seifmostafa73/3D-Printer/BRD.png

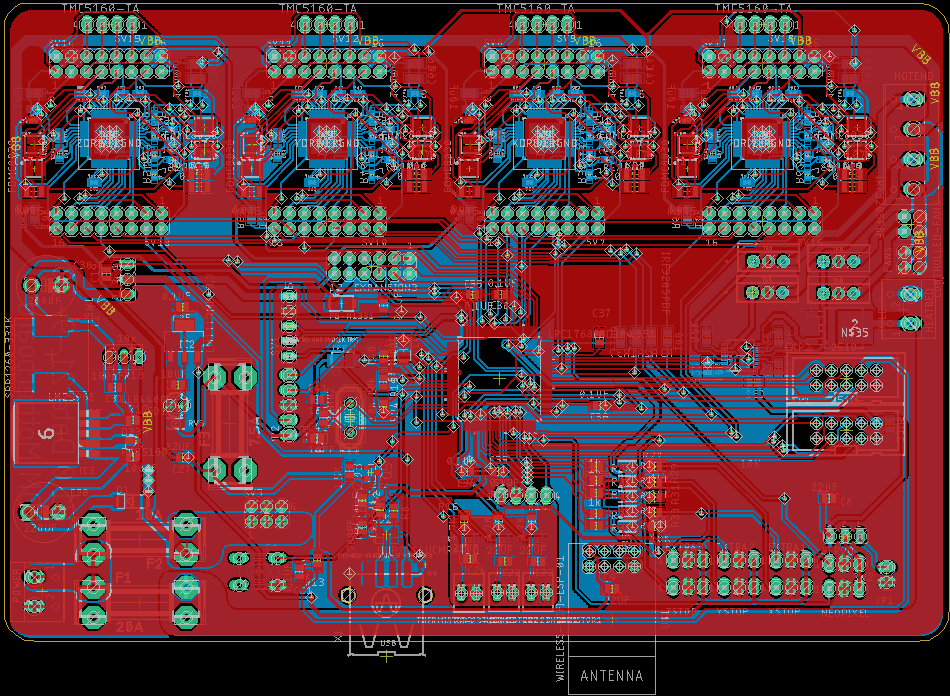
BRD.png
