seifmostafa73/3D-Printer/FDM/Motherboard/Motherboard.png

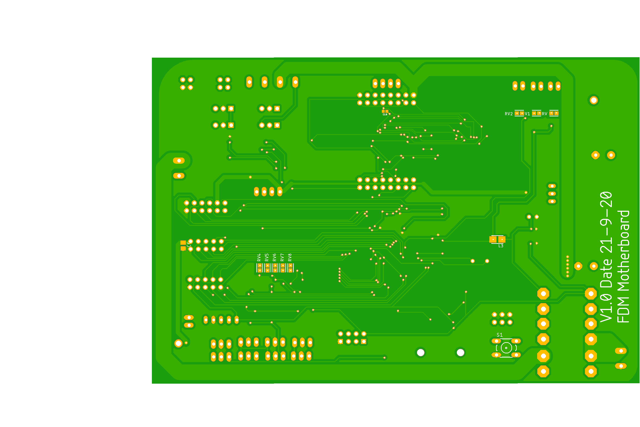
FDM/Motherboard/Motherboard.png
