seifmostafa73/3D-Printer/FDM/TMC5160/TMC5160.png

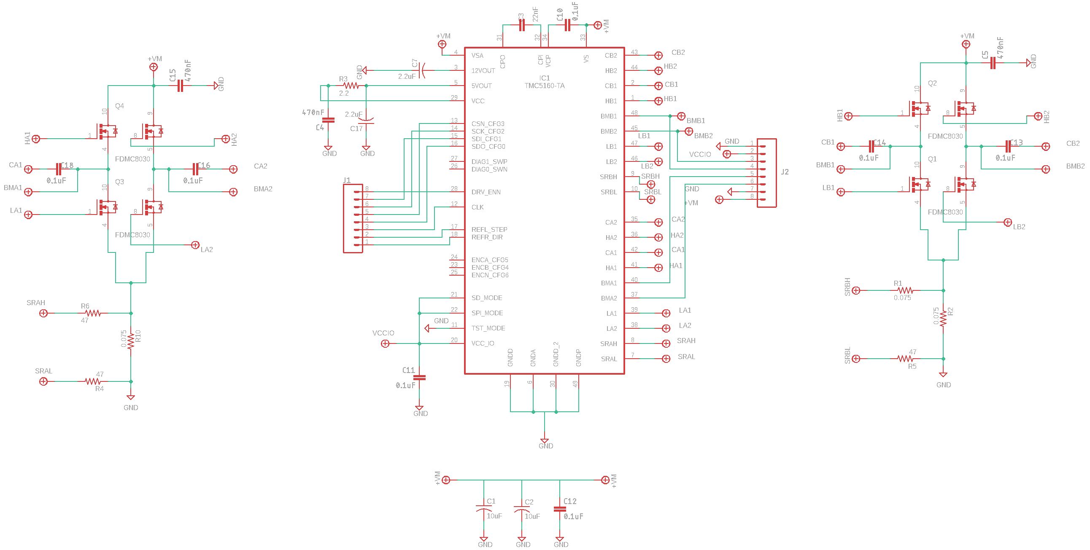
FDM/TMC5160/TMC5160.png
