seifmostafa73/3D-Printer/image.png

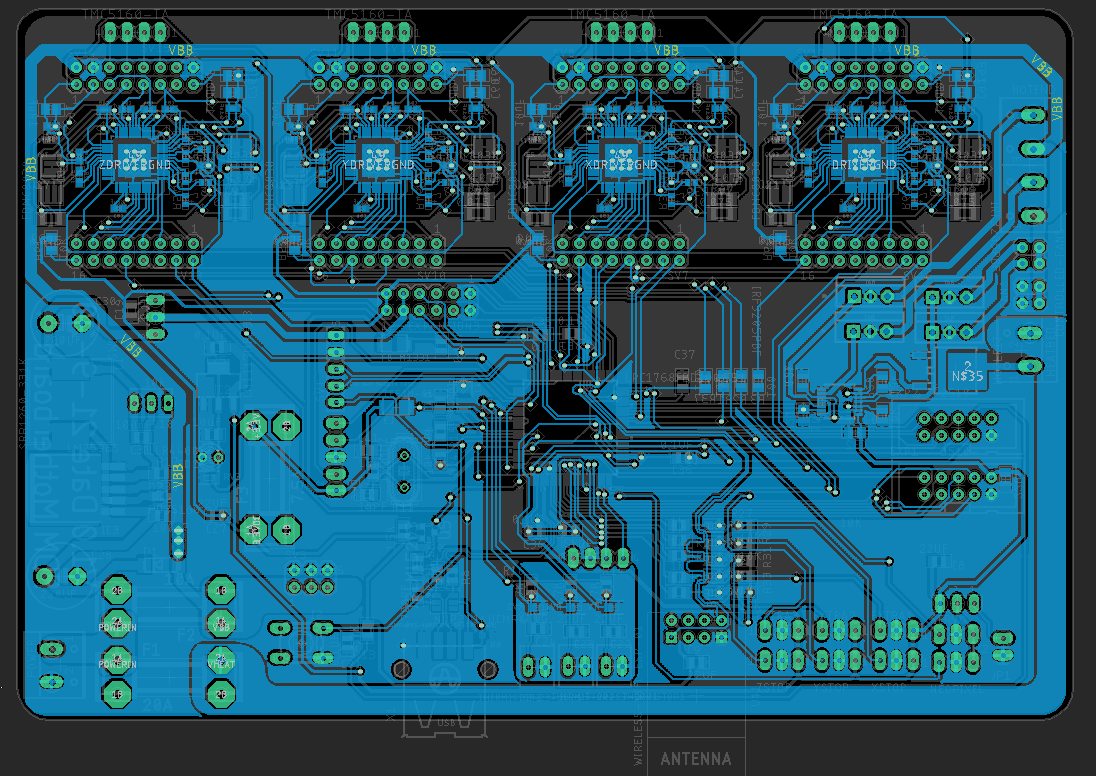
image.png
