seifmostafa73/3D-Printer/MouserBOMv1.1.xls

SHOPPING BASKET
This is not an invoice
24-Apr-22 10:15:26
 | Mouser No | Mfr. No | Manufacturer | Customer No | Description | RoHS | Lifecycle | Order Qty. | Price (EUR) | Ext.: (EUR)
1 | 653-B3F-1025 | B3F-1025 | Omron |  | Tactile Switches 6MM Tactile Switch 260GF 5.0MM | RoHS Compliant |  | 1 | 0,382 € | 0,38 €
2 | 511-SMA6T36AY | SMA6T36AY | STMicroelectronics |  | ESD Suppressors / TVS Diodes Automotive 600 W, 30.8 V TVS in SMA | RoHS Compliant | New Product | 3 | 0,683 € | 2,05 €
3 | 640-USB1046GF0190LBA | USB1046-GF-0190-L-B-A | Global Connector Technology (GCT) |  | USB Connectors USB A Skt, Top Mount, SMT, R/A, GF, Black, With 1.9mm shell stake, T&R | RoHS Compliant | New Product | 1 | 0,683 € | 0,68 €
4 | 667-ERJ-8BWFR075V | ERJ-8BWFR075V | Panasonic |  | Current Sense Resistors - SMD 1206 0.075ohm 1% Curr Sense AEC-Q200 | RoHS Compliant By Exemption |  | 15 | 0,541 € | 8,12 €
5 | 80-C0805C104K8RAUTO | C0805C104K8RACAUTO | KEMET |  | Multilayer Ceramic Capacitors MLCC - SMD/SMT 10Vo 0.1uF X7R 0805 10% AEC-Q200 | RoHS Compliant | New Product | 15 | 0,062 € | 0,93 €
6 | 80-C0402C104K4P | C0402C104K4PACTU | KEMET |  | Multilayer Ceramic Capacitors MLCC - SMD/SMT 16V 0.1uF X5R 0402 10% | RoHS Compliant |  | 35 | 0,042 € | 1,47 €
7 | 652-CR0805FX-1501ELF | CR0805-FX-1501ELF | Bourns |  | Thick Film Resistors - SMD 1.5K 1% | RoHS Compliant By Exemption |  | 5 | 0,091 € | 0,46 €
8 | 652-CR0805FX-1000ELF | CR0805-FX-1000ELF | Bourns |  | Thick Film Resistors - SMD 100ohm 1% | RoHS Compliant By Exemption |  | 10 | 0,026 € | 0,26 €
9 | 581-08055C104K | 08055C104KAT2A | Kyocera AVX |  | Multilayer Ceramic Capacitors MLCC - SMD/SMT 50V 0.1uF X7R 0805 10% | RoHS Compliant By Exemption |  | 5 | 0,146 € | 0,73 €
10 | 603-AR0805JR-0710KL | AR0805JR-0710KL | YAGEO |  | Thick Film Resistors - SMD 10kOhms 1/8W 0805 5% | RoHS Compliant By Exemption |  | 20 | 0,293 € | 5,86 €
11 | 80-C0805L106K8P | C0805L106K8PACTU | KEMET |  | Multilayer Ceramic Capacitors MLCC - SMD/SMT 10V 10uF X5R 0805 | RoHS Compliant |  | 20 | 0,491 € | 9,82 €
12 | 652-3296Y-1-103LF | 3296Y-1-103LF | Bourns |  | Trimmer Resistors - Through Hole 3/8" 10Kohms Sealed Vertical Adjust | RoHS Compliant By Exemption |  | 3 | 2,21 € | 6,63 €
13 | 80-C0805C180G4HACTU | C0805C180G4HACTU | KEMET |  | Multilayer Ceramic Capacitors MLCC - SMD/SMT 16V 18pF X8R 0805 2% | RoHS Compliant |  | 5 | 0,164 € | 0,82 €
14 | 652-CR0805JW-105ELF | CR0805-JW-105ELF | Bourns |  | Thick Film Resistors - SMD 1M 5% | RoHS Compliant By Exemption |  | 3 | 0,091 € | 0,27 €
15 | 652-CR0805FX-1001ELF | CR0805-FX-1001ELF | Bourns |  | Thick Film Resistors - SMD 1K 1% | RoHS Compliant By Exemption |  | 10 | 0,026 € | 0,26 €
16 | 652-CR0402-J/-2R2GLF | CR0402-J/-2R2GLF | Bourns |  | Thick Film Resistors - SMD 2.2OHM 1/16WATT 5% | RoHS Compliant By Exemption |  | 10 | 0,018 € | 0,18 €
17 | 80-C0402C225K9P | C0402C225K9PACTU | KEMET |  | Multilayer Ceramic Capacitors MLCC - SMD/SMT 6.3V 2.2uF X5R 0402 10% | RoHS Compliant |  | 12 | 0,21 € | 2,52 €
18 | 667-EEU-FS1K221B | EEU-FS1K221B | Panasonic |  | Aluminium Electrolytic Capacitors - Radial Leaded 80VDC 220uF 1120mA Polar | RoHS Compliant |  | 2 | 1,08 € | 2,16 €
19 | 80-C0805C226K7PACTU | C0805C226K7PACTU | KEMET |  | Multilayer Ceramic Capacitors MLCC - SMD/SMT 4V 22uF X5R 0805 10% | RoHS Compliant |  | 10 | 0,321 € | 3,21 €
20 | 80-C0603C223M5RAUTO | C0603C223M5RACAUTO | KEMET |  | Multilayer Ceramic Capacitors MLCC - SMD/SMT 50V 0.022uF 0603 X7R 20% AEC-Q200 | RoHS Compliant |  | 6 | 0,328 € | 1,97 €
21 | 652-CR0805FX-27R0ELF | CR0805-FX-27R0ELF | Bourns |  | Thick Film Resistors - SMD 27ohm 1% | RoHS Compliant By Exemption |  | 5 | 0,091 € | 0,46 €
22 | 652-CR0805FX-3300ELF | CR0805-FX-3300ELF | Bourns |  | Thick Film Resistors - SMD 330ohm 1% | RoHS Compliant By Exemption |  | 3 | 0,091 € | 0,27 €
23 | 652-CR0805FX-4701ELF | CR0805-FX-4701ELF | Bourns |  | Thick Film Resistors - SMD 4.7K 1% | RoHS Compliant By Exemption |  | 5 | 0,091 € | 0,46 €
24 | 652-CR0805JW-470ELF | CR0805-JW-470ELF | Bourns |  | Thick Film Resistors - SMD 47ohm 5% | RoHS Compliant By Exemption |  | 15 | 0,022 € | 0,33 €
25 | 80-C0805C472F3GEAULR | C0805C472F3GECAUTO7210 | KEMET |  | Multilayer Ceramic Capacitors MLCC - SMD/SMT 25V 4700pF C0G 0805 1% AEC-Q200 | RoHS Compliant |  | 1 | 1,27 € | 1,27 €
26 | 603-CC402KRX5R5BB474 | CC0402KRX5R5BB474 | YAGEO |  | Multilayer Ceramic Capacitors MLCC - SMD/SMT 6.3V 0.47uF X5R 0402 10% | RoHS Compliant |  | 15 | 0,03 € | 0,45 €
27 | 652-CG0603MLC-3.3LE | CG0603MLC-3.3LE | Bourns |  | ESD Suppressors / TVS Diodes CHIP GUARD 3.3VOLT LOW LEAKAGE | RoHS Compliant |  | 10 | 0,297 € | 2,97 €
28 | 710-782631222 | 782631222 | Wurth Elektronik |  | Ferrite Beads WE-CBA 0603 100MHz 150mA 2200Ohm AECQ2 | RoHS Compliant |  | 3 | 0,228 € | 0,68 €
29 | 512-FDMC8030 | FDMC8030 | onsemi |  | MOSFET FPS | RoHS Compliant |  | 16 | 1,04 € | 16,64 €
30 | 942-IRF3205PBF | IRF3205PBF | Infineon |  | MOSFET MOSFT 55V 98A 8mOhm 97.3nC | RoHS Compliant |  | 4 | 1,62 € | 6,48 €
31 | 942-IRLML5203TRPBF | IRLML5203TRPBF | Infineon |  | MOSFET MOSFT P-Ch -30V -3A 98mOhm 9.5nC Log Lvl | RoHS Compliant |  | 1 | 0,555 € | 0,56 €
32 | 942-IRLR8743TRPBF | IRLR8743TRPBF | Infineon |  | MOSFET 30V 1 N-CH HEXFET 3.1mOhms 39nC | RoHS Compliant |  | 1 | 1,42 € | 1,42 €
33 | 926-LM1117MPX-33 | LM1117MPX-3.3 | Texas Instruments |  | LDO Voltage Regulators 800-mA 15-V linear voltage regulator 4-SOT-223 | No |  | 1 | 1,61 € | 1,61 €
34 | 926-LM2596SX-5.0NOPB | LM2596SX-5.0/NOPB | Texas Instruments |  | Switching Voltage Regulators 150 KHZ 3A STEP-DOWN VLTG REG | RoHS Compliant By Exemption |  | 1 | 6,12 € | 6,12 €
35 | 771-LPC1768FBD100K | LPC1768FBD100K | NXP |  | ARM Microcontrollers - MCU 512kB flash, 64kB SRAM, Ethernet, USB, LQFP100 package | RoHS Compliant |  | 1 | 14,44 € | 14,44 €
36 | 863-MC74HCT125ADTR2G | MC74HCT125ADTR2G | onsemi |  | Buffers & Line Drivers BUFF/DVR TRI-ST QD | RoHS Compliant |  | 1 | 0,582 € | 0,58 €
37 | 863-NUP2114UCMR6T1G | NUP2114UCMR6T1G | onsemi |  | ESD Suppressors / TVS Diodes LOW CAP TVS ARRAY | RoHS Compliant |  | 1 | 0,501 € | 0,50 €
38 | 621-PD3S160Q-7 | PD3S160Q-7 | Diodes Incorporated |  | Schottky Diodes & Rectifiers 1.0A Schottky Rec 60Vrrm 42Vr 22A Ifsm | RoHS Compliant |  | 1 | 0,437 € | 0,44 €
39 | 652-SRR1260-331K | SRR1260-331K | Bourns |  | Fixed Inductors 330uH 10% SMD 1260 | RoHS Compliant |  | 1 | 1,26 € | 1,26 €
40 | 78-TLLR4400 | TLLR4400 | Vishay |  | Standard LEDs - Through Hole Red Tinted Diffused | RoHS Compliant |  | 1 | 0,428 € | 0,43 €
By submitting your order you agree to these terms and conditions. (https://eu.mouser.com/saleterms) |  |  |  |  |  |  |  |  | Merchandise: | 106,15 €
Prices are reflected at the date and time shown. |  |  |  |  |  |  |  |  | Delivery Charge: | 0,00 €
 |  |  |  |  |  |  |  |  | Back-order Delivery: | 0,00 €
