seifmostafa73/3D-Printer/FDM/TMC5160/Sch1.brd

## EAGLE design FDM/TMC5160/Sch1.brd (2022-03-11)

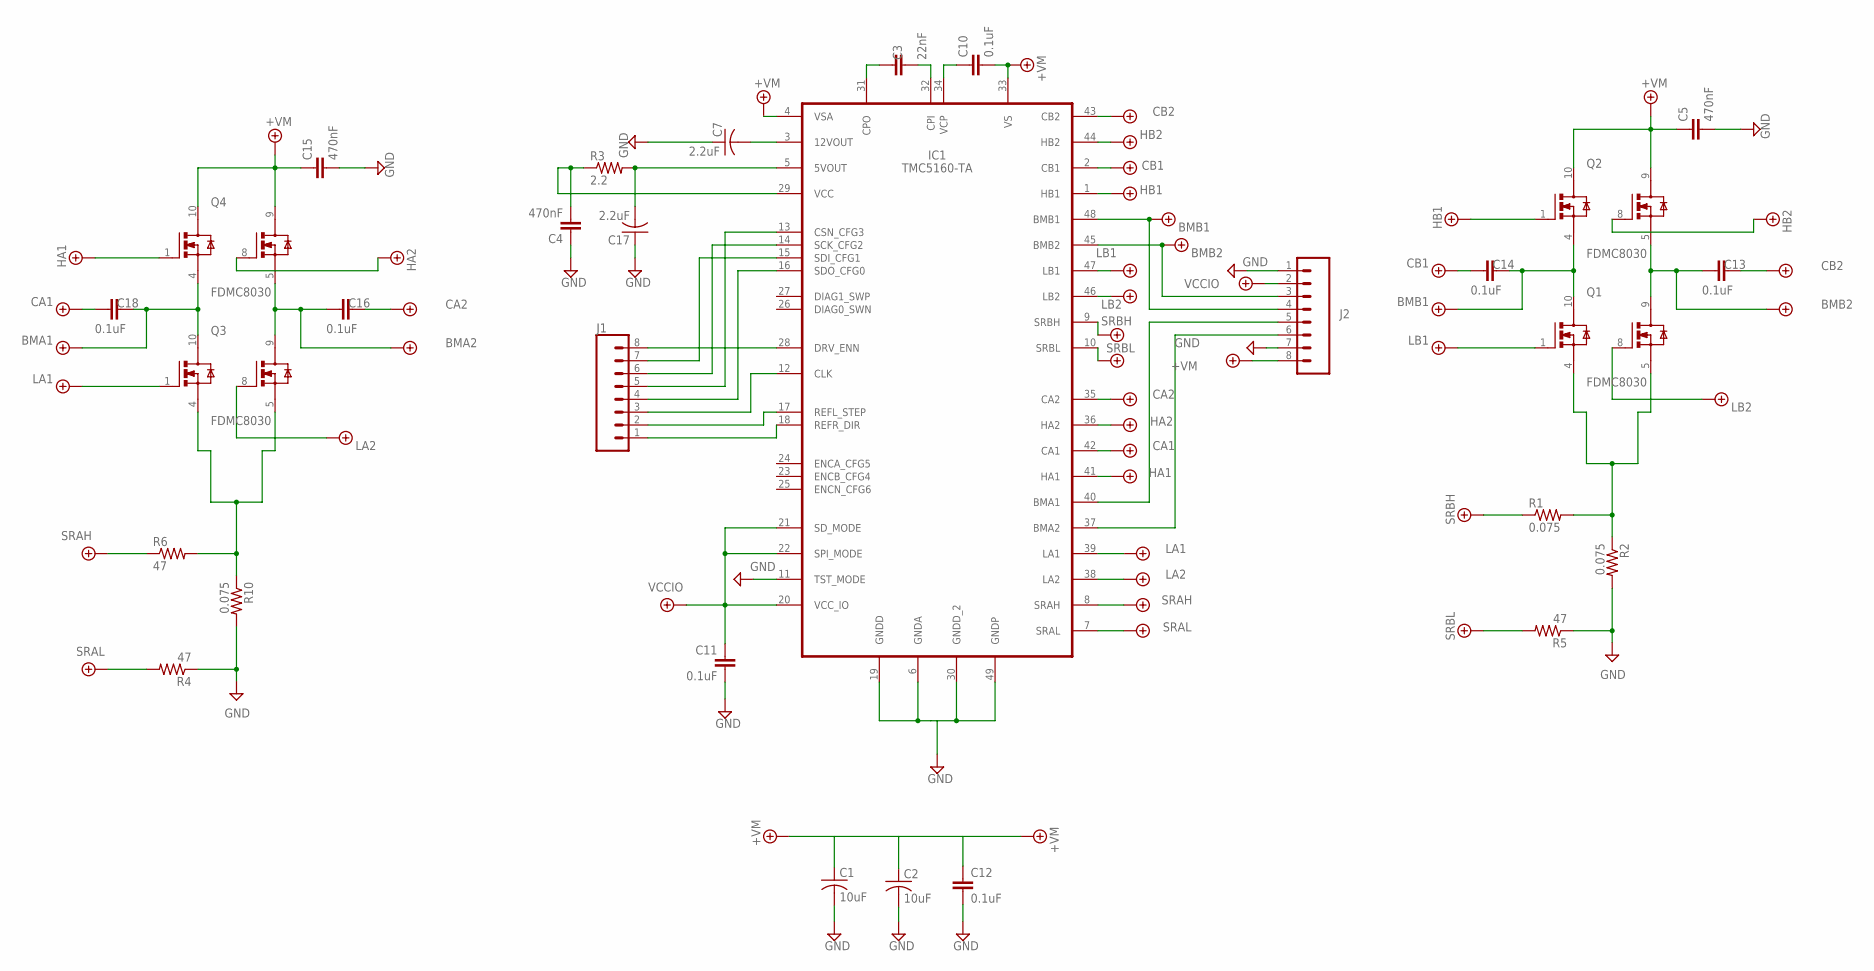
[picture p5: schematic Sch1.sch]

Parts:
C1, C2: 10uF; C0805
C3: 22nF; 0603
C4, C5, C15: 470nF; 0402
C7, C17: 2.2uF; C0402
C10, C11, C12, C13, C14, C16, C18: 0.1uF; 0402
IC1: TMC5160-TA; TQFP48-EP
J1, J2: CONN_08"; 1X08
Q1, Q2, Q3, Q4: FDMC8030; TRANS_FDMC8030
R1, R2, R10: 0.075; R1206
R3: 2.2; R0402
R4, R5, R6: 47; R0402

Connections:
+5V: C11.1, IC1.20 (VCC_IO), IC1.21 (SD_MODE), IC1.22 (SPI_MODE), J2.2
-4.1V: C1.1, C2.1, C5.1, C10.2, C12.1, C13.1, C13.2, C14.1, C14.2, C15.1, C16.1, C16.2, C18.1, C18.2, IC1.1 (HB1), IC1.2 (CB1), IC1.4 (VSA), IC1.7 (SRAL), IC1.8 (SRAH), IC1.9 (SRBH), IC1.10 (SRBL), IC1.33 (VS), IC1.35 (CA2), IC1.36 (HA2), IC1.38 (LA2), IC1.39 (LA1), IC1.41 (HA1), IC1.42 (CA1), IC1.43 (CB2), IC1.44 (HB2), IC1.45 (BMB2), IC1.46 (LB2), IC1.47 (LB1), IC1.48 (BMB1), J2.3, J2.4, J2.8, Q1.1 (G1), Q1.8 (G2), Q1.9 (D2), Q1.10 (D1), Q2.1 (G1), Q2.4 (S1), Q2.5 (S2), Q2.8 (G2), Q2.9 (D2), Q2.10 (D1), Q3.1 (G1), Q3.8 (G2), Q3.9 (D2), Q3.10 (D1), Q4.1 (G1), Q4.4 (S1), Q4.5 (S2), Q4.8 (G2), Q4.9 (D2), Q4.10 (D1), R1.1, R4.2, R5.2, R6.1
GND: C1.2, C2.2, C4.1, C5.2, C7.1, C11.2, C12.2, C15.2, C17.1, IC1.6 (GNDA), IC1.11 (TST_MODE), IC1.19 (GNDD), IC1.30 (GNDD_2), IC1.49 (GNDP), J2.1, J2.7, R2.2, R4.1, R5.1, R10.2
unnamed: C10.1, IC1.34 (VCP)
unnamed: IC1.18 (REFR_DIR), J1.1
unnamed: C3.1, IC1.31 (CPO)
unnamed: C3.2, IC1.32 (CPI)
unnamed: C7.2, IC1.3 (12VOUT)
unnamed: C17.2, IC1.5 (5VOUT), R3.2
unnamed: C4.2, IC1.29 (VCC), R3.1
unnamed: IC1.17 (REFL_STEP), J1.2
unnamed: IC1.12 (CLK), J1.3
unnamed: IC1.16 (SDO_CFG0), J1.4
unnamed: IC1.13 (CSN_CFG3), J1.5
unnamed: IC1.14 (SCK_CFG2), J1.6
unnamed: IC1.15 (SDI_CFG1), J1.7
unnamed: IC1.28 (DRV_ENN), J1.8
unnamed: IC1.40 (BMA1), J2.5
unnamed: IC1.37 (BMA2), J2.6
unnamed: Q3.4 (S1), Q3.5 (S2), R6.2, R10.1
unnamed: Q1.4 (S1), Q1.5 (S2), R1.2, R2.1

Board: 2 copper layers, 29 parts (0 on the bottom side), 21 nets, no tracks yet.
