seifmostafa73/3D-Printer/FDM/Motherboard/Motherboard V1.1.brd

## EAGLE design FDM/Motherboard/Motherboard V1.1.brd (2022-03-11)

Schematic: Motherboard V1.1.sch, sheet 1

Parts:
C6, C8, C9, C22, C23, C24, C27: 22UF; C0805
C19, C21, C25, C32, C33, C34, C35, C36, C37, C38, C39, C40: 0.1UF; C0805
C20: 4700PF; C0805
C26: 10UF; C0805
C28: 220UF; E5-10,5
C29, C31: 100nF; C0805
C30: 200UF; E5-10,5
C41, C42: 18PF; C0805
C44, C45, C59, C60, C61, C75, C76, C77, C91, C92, C93, C107: 10uF; C0805
C46, C62, C78, C94: 22nF; 0603
C47, C55, C58, C63, C71, C74, C79, C87, C90, C95, C103, C106: 470nF; 0402
C48, C54, C64, C70, C80, C86, C96, C102: 2.2uF; C0402
C49, C50, C51, C52, C53, C56, C57, C65, C66, C67, C68, C69, C72, C73, C81, C82, C83, C84, C85, C88, C89, C97, C98, C99, C100, C101, C104, C105: 0.1uF; 0402
CONTROLLED-FANS: PINHD-2X2; 2X02
D1: DIODE-DO214AA; DO214AA
D2: PD3S160; POWERDI323
EXP1, EXP2: 2510-; PAK100/2500-10
EXPANSION3: MA06-2
EXTRA1, EXTRA2, EXTRA3: MA03-1
F1: 20A; SHK20Q
F2: 10A; SHK20Q
F3: 7.5A; SHK20Q
FANS: PINHD-2X2; 2X02
HEATBED: W237-102
HOTEND: W237-04P; W237-4P
IC2: LM1117MP-3.3; SOT223
IC3: LM2596S; TO263-5
IC4, IC5, IC6, IC7: TMC5160-TA; TQFP48-EP
JP1: PINHD-1X2; 1X02
JP2: swd; 1X05
L1: SRR1260-331K; INDP125125X600N
L2, L3, L4: FB-M1331; M1331
LED1: TLLR4400; LED3MM
MOSFET1: IRLR8743PBFD-PAK_TO-252AA_INF-L; D-PAK_TO-252AA_INF-L
NEOPIXEL: MA03-1
POWER: W237-102
Q5: IRLML5203; MICRO3
Q6: 120MHZ; HC49/S
Q7, Q8, Q9, Q10, Q11, Q12, Q13, Q14, Q15, Q16, Q17, Q18, Q19, Q20, Q21, Q22: FDMC8030; TRANS_FDMC8030
R1, R2, R3, R37: 100; R0805
R7, R8: 27; R0805
R9: SMD-RES-VARISTOR-5V-28V(0603); R0603
R11, R12: 1.5K; R0805
R13, R14, R15, R16: 4.7K; R0805
R17: 330; R0805
R18: 10k; B64Y
R19, R20, R21, R22, R23, R24, R45, R53, R61, R69: 10k; R0805
R25: 1M; R0805
R26, R28, R30, R32, R34: 1k; R0805
R27, R29, R31, R33, R35: 10K; R0805
R38, R39, R43, R46, R47, R51, R54, R55, R59, R62, R63, R67: 47; R0402
R40, R41, R44, R48, R49, R52, R56, R57, R60, R64, R65, R68: 0.075; R1206
R42, R50, R58, R66: 2.2; R0402
RV, RV1, RV2, RV3, RV4, RV5, RV6, RV7, RV8: BOURNS_INC._CG0603MLC-3.3LEBOURNS_INC._CG0603MLC-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; BOURNS_INC._CG0603MLC-3.3LE_1
S1: 10-XX; B3F-10XX
SERVO: MA03-1
SV1: FE05-1
SV2, SV9, SV12, SV15, SV18: MA04-1
SV3: MA03-2
SV7, SV8, SV10, SV11, SV13, SV14, SV16, SV17: MA08-2
SW1, SW2: JP2E; JP2
THERMISTOR1, THERMISTOR2, THERMISTOR3: 22-23-2021
U1: LPC1768FBD100,551; LQFP100_14X14_NXP
U2: NUP2114UCMR6T1G; SOP95P275X110-6N
U3: MC74HCT125ADTR2GTSSOP14_4P50X5P10_ONS-L; TSSOP14_4P50X5P10_ONS-L
U4, U5, U6, U7: IRF3205PBF; PG-TO220-3_INF
U$1: WIRELESS-WIFI-ESP-01
X1: USB-A003
XSTOP: MA03-1
YSTOP: MA03-1
ZSTOP: MA03-1

Connections:
1A: SV17.10, SV18.2
1B: SV17.12, SV18.1
2A: SV17.8, SV18.3
2B: SV17.6, SV18.4
3.3VDC: C9.1, C27.1, EXPANSION3.11, EXPANSION3.12, F3.1A, Q5.2 (S), R11.2, R13.1, R27.2, R29.2, R31.2, R33.2, R35.2, R45.1, R53.1, R61.1, R69.1, SV8.14, SV11.14, SV14.14, SV17.14, U$1.D2 (VCC)
5V-OUT: C30.+, C31.2, L1.1, R18.A, SW1.3
+3.3V: C26.1, F3.2A, IC2.2 (OUT), IC2.4 (OUT), JP2.1, L2.1, L3.1, LED1.A, RV3.2
+5V: C6.1, C8.2, C25.1, C32.2, EXP1.10, EXPANSION3.9, EXPANSION3.10, EXTRA1.3, EXTRA2.3, EXTRA3.3, IC2.3 (IN), SV1.5, SV2.1, SW1.2, SW2.3, U3.14 (VCC), XSTOP.3, YSTOP.3, ZSTOP.3
AGND: C22.1, C23.1, C24.1, L4.2, RV.1, RV1.1, RV2.1, THERMISTOR1.2, THERMISTOR2.2, THERMISTOR3.2, U1.11 (VSSA), U1.15 (VREFN)
BMA1: C105.2, IC7.40 (BMA1), Q21.10 (D1), Q22.4 (S1), SV17.9
BMA2: C104.1, IC7.37 (BMA2), Q21.9 (D2), Q22.5 (S2), SV17.7
BMB1: C101.2, IC7.48 (BMB1), Q19.10 (D1), Q20.4 (S1), SV17.11
BMB2: C100.1, IC7.45 (BMB2), Q19.9 (D2), Q20.5 (S2), SV17.5
CA1: C105.1, IC7.42 (CA1)
CA2: C104.2, IC7.35 (CA2)
CB1: C101.1, IC7.2 (CB1)
CB2: C100.2, IC7.43 (CB2)
CRYSTAL_N: C42.2, Q6.2, R25.1, U1.23 (XTAL2)
CRYSTAL_P: C41.2, Q6.1, R25.2, U1.22 (XTAL1)
DIR: IC7.18 (REFR_DIR), SV16.1
DPIN_N: R8.1, U1.30 (P0[30]/USB_D-)
DPIN_P: R7.1, R12.1, U1.29 (P0[29]/USB_D+)
DRIVERGND: C92.2, C93.2, C95.2, C96.1, C98.2, C99.2, C102.1, C103.2, C106.1, C107.2, IC7.6 (GNDA), IC7.11 (TST_MODE), IC7.19 (GNDD), IC7.30 (GNDD_2), IC7.49 (GNDP), R62.1, R65.2, R67.1, R68.2, SV17.3, SV17.15
DRIVERVBB: C92.1, C93.1, C95.1, C97.2, C99.1, C103.1, C107.1, IC7.4 (VSA), IC7.33 (VS), Q20.9 (D2), Q20.10 (D1), Q22.9 (D2), Q22.10 (D1), SV17.1
DRIVERVSS: C98.1, IC7.20 (VCC_IO), IC7.21 (SD_MODE), IC7.22 (SPI_MODE), SV17.13
D_N: R8.2, U2.6 (I/O), X1.3
D_P: R7.2, U2.1 (I/O), X1.2
E0-DIR: SV16.2, U1.49 (P0[11]/RXD2/SCL2/MAT3[1])
E0-RX: SV16.10, U1.93 (P1[4]/ENET_TX_EN)
E0-SLP: SV16.6
E0-STP: SV16.4, U1.50 (P2[13]/!EINT3/I2STX_SDA)
ENABLE: IC7.28 (DRV_ENN), SV16.15
ESP_N: U1.85 (P4[29]/TX_MCLK/MAT2[1]/RXD3), U$1.A2 (UTXD)
ESP_P: U1.82 (P4[28]/RX_MCLK/MAT2[0]/TXD3), U$1.D1 (URXD)
EXTRA1: R32.2, U1.40 (P1[26]/MCOB1/PWM1[6]/CAP0[0])
EXTRA2: R34.2, U1.39 (P1[25]/MCOA1/MAT1[1])
FANMOSFET: U3.11 (Y4), U6.1 (G), U7.1 (G)
FANPWM: R23.1, U1.70 (P2[3]/PWM1[4]/DCD1/TRACEDATA[2]), U3.12 (A4)
GND: C6.2, C8.1, C9.2, C19.1, C20.1, C21.2, C25.2, C26.2, C27.2, C28.-, C29.2, C30.-, C32.1, C33.1, C34.1, C35.1, C36.1, C37.1, C38.1, C39.1, C40.2, C41.1, C42.1, D2.A, EXP1.9, EXP2.9, EXPANSION3.1, EXPANSION3.2, EXTRA1.2, EXTRA2.2, EXTRA3.2, FANS.2, FANS.4, IC2.1 (GND), IC3.3 (GND), IC3.5 (!ON!/OFF), JP1.1, JP2.3, L4.1, LED1.K (C), MOSFET1.3 (S), NEOPIXEL.2, POWER.2, R9.2, R17.2, R20.2, R21.2, R22.2, R23.2, RV3.1, RV4.2, RV5.2, RV6.2, RV7.2, RV8.2, S1.3, SERVO.2, SV1.4, SV2.2, SV3.2, SV3.4, SV3.6, SV8.4, SV8.16, SV11.4, SV11.16, SV14.4, SV14.16, SV17.4, SV17.16, U1.31 (VSS_2), U1.41 (VSS_3), U1.55 (VSS_4), U1.72 (VSS_5), U1.83 (VSS_6), U1.97 (VSS), U3.1 (OE1), U3.4 (OE2), U3.7 (GND), U3.10 (OE3), U3.13 (OE4), U4.2 (S), U5.2 (S), U6.2 (S), U7.2 (S), U$1.A1 (GND), X1.1, XSTOP.2, YSTOP.2, ZSTOP.2
HA1: IC7.41 (HA1), Q22.1 (G1)
HA2: IC7.36 (HA2), Q22.8 (G2)
HB1: IC7.1 (HB1), Q20.1 (G1)
HB2: IC7.44 (HB2), Q20.8 (G2)
HBMOSFET: MOSFET1.1 (G), U3.8 (Y3)
HBPWM: R20.1, U1.68 (P2[5]/PWM1[6]/DTR1/TRACEDATA[0]), U3.9 (A3)
HEMOSFET1: U3.6 (Y2), U5.1 (G)
HEMOSFET2: U3.3 (Y1), U4.1 (G)
HEPWM1: R21.1, U1.66 (P2[7]/RD2/RTS1), U3.5 (A2)
HEPWM2: R22.1, U1.69 (P2[4]/PWM1[5]/DSR1/TRACEDATA[1]), U3.2 (A1)
LA1: IC7.39 (LA1), Q21.1 (G1)
LA2: IC7.38 (LA2), Q21.8 (G2)
LB1: IC7.47 (LB1), Q19.1 (G1)
LB2: IC7.46 (LB2), Q19.8 (G2)
MISO: EXPANSION3.5, U1.77 (P0[8]/I2STX_WS/MISO1/MAT2[2])
MOSI: EXPANSION3.3, U1.76 (P0[9]/I2STX_SDA/MOSI1/MAT2[3])
MOT-EN: R3.1, R69.2, SV16.16
MOT-MISO: SV7.8, SV10.8, SV13.8, SV16.8, U1.80 (P0[5]/I2SRX_WS/TD2/CAP2[1])
MOT-MOSI: SV7.14, SV10.14, SV13.14, SV16.14, U1.86 (P1[17]/ENET_MDIO)
MOT-SCK: SV7.12, SV10.12, SV13.12, SV16.12, U1.81 (P0[4]/I2SRX_CLK/RD2/CAP2[0])
MOTORMISO: IC7.16 (SDO_CFG0), SV16.7
MOTORMOSI: IC7.15 (SDI_CFG1), SV16.13
MOTORSCK: IC7.14 (SCK_CFG2), SV16.11
unnamed: EXP1.1, U1.21 (P1[30]/VBUS/AD0[4])
unnamed: EXP1.2, U1.24 (P0[28]/SCL0/USB_SCL)
unnamed: EXP1.3, U1.32 (P1[18]/USB_UP_LED/PWM1[1]/CAP1[0])
unnamed: EXP1.4, U1.33 (P1[19]/MCOA0/!USB_PPWR/CAP1[1])
unnamed: EXP1.5, U1.34 (P1[20]/MCI0/PWM1[2]/SCK0)
unnamed: EXP1.6, U1.35 (P1[21]/!MCABORT/PWM1[3]/SSEL0)
unnamed: EXP1.7, U1.36 (P1[22]/MCOB0/USB_PWRD/MAT1[0])
unnamed: EXP1.8, U1.37 (P1[23]/MCI1/PWM1[4]/MISO0)
unnamed: R1.2, U1.65 (P2[8]/TD2/TXD2)
unnamed: R2.2, U1.57 (P0[21]/RI1/RD1)
unnamed: EXP2.1, U1.61 (P0[17]/CTS1/MISO0/MISO)
unnamed: EXP2.2, U1.62 (P0[15]/TXD1/SCK0/SCK)
unnamed: EXP2.3, U1.26 (P3[26]/STCLK/MAT0[1]/PWM1[3])
unnamed: EXP2.4, U1.63 (P0[16]/RXD1/SSEL0/SSEL)
unnamed: EXP2.5, U1.27 (P3[25]/MAT0[0]/PWM1[2])
unnamed: EXP2.6, U1.60 (P0[18]/DCD1/MOSI0/MOSI)
unnamed: EXP2.7, U1.20 (P1[31]/SCK1/AD0[5])
unnamed: R3.2, U1.51 (P2[12]/!EINT2/I2STX_WS)
unnamed: R37.2, U1.74 (P2[1]/PWM1[2]/RXD1)
unnamed: C49.1, IC4.34 (VCP)
unnamed: C46.1, IC4.31 (CPO)
unnamed: C46.2, IC4.32 (CPI)
unnamed: C48.2, IC4.3 (12VOUT)
unnamed: C54.2, IC4.5 (5VOUT), R42.2
unnamed: C58.2, IC4.29 (VCC), R42.1
unnamed: Q7.4 (S1), Q7.5 (S2), R40.2, R41.1
unnamed: Q9.4 (S1), Q9.5 (S2), R39.2, R44.1
unnamed: C65.1, IC5.34 (VCP)
unnamed: C20.2, U2.2 (VN)
unnamed: HEATBED.1, MOSFET1.2 (D)
unnamed: Q5.3 (D), R12.2
unnamed: C31.1, IC3.4 (FB), R17.1, R18.S
unnamed: C28.+, C29.1, D1.C, IC3.1 (VIN)
unnamed: D2.C, IC3.2 (OUT), L1.2
unnamed: CONTROLLED-FANS.4, U6.3 (D)
unnamed: HOTEND.4, U4.3 (D)
unnamed: HOTEND.2, U5.3 (D)
unnamed: CONTROLLED-FANS.2, U7.3 (D)
unnamed: R19.1, U1.14 (!RSTOUT)
unnamed: R24.1, U1.16 (RTCX1)
unnamed: C62.1, IC5.31 (CPO)
unnamed: C62.2, IC5.32 (CPI)
unnamed: C64.2, IC5.3 (12VOUT)
unnamed: C70.2, IC5.5 (5VOUT), R50.2
unnamed: C74.2, IC5.29 (VCC), R50.1
unnamed: R26.1, R27.1, RV4.1, XSTOP.1
unnamed: EXTRA1.1, R32.1, R33.1, RV7.1
unnamed: Q11.4 (S1), Q11.5 (S2), R48.2, R49.1
unnamed: Q13.4 (S1), Q13.5 (S2), R47.2, R52.1
unnamed: R28.1, R29.1, RV5.1, YSTOP.1
unnamed: R30.1, R31.1, RV6.1, ZSTOP.1
unnamed: C81.1, IC6.34 (VCP)
unnamed: C78.1, IC6.31 (CPO)
unnamed: C78.2, IC6.32 (CPI)
unnamed: C80.2, IC6.3 (12VOUT)
unnamed: EXTRA2.1, R34.1, R35.1, RV8.1
unnamed: C86.2, IC6.5 (5VOUT), R58.2
unnamed: C90.2, IC6.29 (VCC), R58.1
unnamed: Q15.4 (S1), Q15.5 (S2), R56.2, R57.1
unnamed: Q17.4 (S1), Q17.5 (S2), R55.2, R60.1
unnamed: C97.1, IC7.34 (VCP)
unnamed: C94.1, IC7.31 (CPO)
unnamed: C94.2, IC7.32 (CPI)
unnamed: C96.2, IC7.3 (12VOUT)
unnamed: C102.2, IC7.5 (5VOUT), R66.2
unnamed: C106.2, IC7.29 (VCC), R66.1
unnamed: Q19.4 (S1), Q19.5 (S2), R64.2, R65.1
unnamed: Q21.4 (S1), Q21.5 (S2), R63.2, R68.1
NPOWER: NEOPIXEL.3, SERVO.3, SW2.2
P0.26: EXPANSION3.7, U1.6 (P0[26]/AD0[3]/AOUT/RXD3)
P0.27: EXPANSION3.8, U1.25 (P0[27]/SDA0/USB_SDA)
P38: NEOPIXEL.1, U1.38 (P1[24]/MCI2/PWM1[5]/MOSI0)
POWERIN: F1.1A, F2.2A, POWER.1
PROBE: EXTRA3.1, U1.48 (P0[10]/TXD2/SDA2/MAT3[0])
RESET: C21.1, EXP2.8, R13.2, S1.1 (S), SV1.1, U1.17 (!RESET)
RX: IC7.13 (CSN_CFG3), SV16.9
RX0: SV1.2, U1.99 (P0[3]/RXD0/AD0[6])
SCK: EXPANSION3.6, U1.78 (P0[7]/I2STX_CLK/SCK1/MAT2[1])
SCL1: SV2.4, U1.47 (P0[1]/TD1/RXD3/SCL1)
SDA1: SV2.3, U1.46 (P0[0]/RD1/TXD3/SDA1)
SERVO: SERVO.1, U1.75 (P2[0]/PWM1[1]/TXD1)
SLP: IC7.12 (CLK), SV16.5
SOFTCONNECT: Q5.1 (G), R11.1, U1.64 (P2[9]/USB_CONNECT/RXD2)
SRAH: IC7.8 (SRAH), R63.1
SRAL: IC7.7 (SRAL), R67.2
SRBH: IC7.9 (SRBH), R64.1
SRBL: IC7.10 (SRBL), R62.2
SSEL: EXPANSION3.4, U1.79 (P0[6]/I2SRX_SDA/SSEL1/MAT2[0])
STP: IC7.17 (REFL_STEP), SV16.3
SWDCLK: JP2.4, U1.5 (TCK/SWDCLK)
SWDIO: JP2.2, U1.3 (TMS/SWDIO)
TH1: C22.2, R14.2, RV.2, THERMISTOR1.1, U1.9 (P0[23]/AD0[0]/I2SRX_CLK/CAP3[0])
TH2: C23.2, R15.2, RV1.2, THERMISTOR2.1, U1.8 (P0[24]/AD0[1]/I2SRX_WS/CAP3[1])
THB: C24.2, R16.2, RV2.2, THERMISTOR3.1, U1.7 (P0[25]/AD0[2]/I2SRX_SDA/TXD3)
TRST: JP2.5, U1.4 (!TRST)
TX0: SV1.3, U1.98 (P0[2]/TXD0/AD0[7])
UC3.3V: C33.2, C34.2, C35.2, C36.2, C37.2, C38.2, C39.2, L2.2, R19.2, R24.2, U1.19 (VBAT), U1.28 (VDD(3V3)_2), U1.42 (VDD(REG)(3V3)_2), U1.54 (VDD(3V3)_3), U1.71 (VDD(3V3)_4), U1.84 (VDD(REG)(3V3)), U1.96 (VDD(3V3))
USB5V: C19.2, R9.1, SW1.1, U2.5 (VP), X1.4
VBB: CONTROLLED-FANS.1, CONTROLLED-FANS.3, D1.A, F2.1A, FANS.1, FANS.3, HOTEND.1, HOTEND.3, SV3.1, SV3.3, SV3.5, SV8.2, SV11.2, SV14.2, SV17.2
VDDA: C40.1, L3.2, R14.1, R15.1, R16.1, U1.10 (VDDA), U1.12 (VREFP)
VHEAT: F1.2A, HEATBED.2
VOT: JP1.2, SW2.1
X1A: SV8.10, SV9.2
X1B: SV8.12, SV9.1
X2A: SV8.8, SV9.3
X2B: SV8.6, SV9.4
X-DIR: SV7.2, U1.67 (P2[6]/PCAP1[0]/RI1/TRACECLK)
X-MOT-EN: R37.1, R45.2, SV7.16
X-RX: SV7.10, U1.90 (P1[10]/ENET_RXD1)
X-SLP: SV7.6
X-STP: SV7.4, U1.73 (P2[2]/PWM1[3]/CTS1/TRACEDATA[3])
XBMA1: C57.2, IC4.40 (BMA1), Q9.10 (D1), Q10.4 (S1), SV8.9
XBMA2: C56.1, IC4.37 (BMA2), Q9.9 (D2), Q10.5 (S2), SV8.7
XBMB1: C53.2, IC4.48 (BMB1), Q7.10 (D1), Q8.4 (S1), SV8.11
XBMB2: C52.1, IC4.45 (BMB2), Q7.9 (D2), Q8.5 (S2), SV8.5
XCA1: C57.1, IC4.42 (CA1)
XCA2: C56.2, IC4.35 (CA2)
XCB1: C53.1, IC4.2 (CB1)
XCB2: C52.2, IC4.43 (CB2)
XDIR: IC4.18 (REFR_DIR), SV7.1
XDRIVERGND: C44.2, C45.2, C47.2, C48.1, C50.2, C51.2, C54.1, C55.2, C58.1, C59.2, IC4.6 (GNDA), IC4.11 (TST_MODE), IC4.19 (GNDD), IC4.30 (GNDD_2), IC4.49 (GNDP), R38.1, R41.2, R43.1, R44.2, SV8.3, SV8.15
XDRIVERVBB: C44.1, C45.1, C47.1, C49.2, C51.1, C55.1, C59.1, IC4.4 (VSA), IC4.33 (VS), Q8.9 (D2), Q8.10 (D1), Q10.9 (D2), Q10.10 (D1), SV8.1
XDRIVERVSS: C50.1, IC4.20 (VCC_IO), IC4.21 (SD_MODE), IC4.22 (SPI_MODE), SV8.13
XENABLE: IC4.28 (DRV_ENN), SV7.15
XHA1: IC4.41 (HA1), Q10.1 (G1)
XHA2: IC4.36 (HA2), Q10.8 (G2)
XHB1: IC4.1 (HB1), Q8.1 (G1)
XHB2: IC4.44 (HB2), Q8.8 (G2)
XLA1: IC4.39 (LA1), Q9.1 (G1)
XLA2: IC4.38 (LA2), Q9.8 (G2)
XLB1: IC4.47 (LB1), Q7.1 (G1)
XLB2: IC4.46 (LB2), Q7.8 (G2)
XMIN: R26.2, U1.45 (P1[29]/MCOB2/PCAP1[1]/MAT0[1])
XMOTORMISO: IC4.16 (SDO_CFG0), SV7.7
XMOTORMOSI: IC4.15 (SDI_CFG1), SV7.13
XMOTORSCK: IC4.14 (SCK_CFG2), SV7.11
XRX: IC4.13 (CSN_CFG3), SV7.9
XSLP: IC4.12 (CLK), SV7.5
XSRAH: IC4.8 (SRAH), R39.1
XSRAL: IC4.7 (SRAL), R43.2
XSRBH: IC4.9 (SRBH), R40.1
XSRBL: IC4.10 (SRBL), R38.2
XSTP: IC4.17 (REFL_STEP), SV7.3
Y1A: SV11.10, SV12.2
Y1B: SV11.12, SV12.1
Y2A: SV11.8, SV12.3
Y2B: SV11.6, SV12.4
Y-DIR: SV10.2, U1.58 (P0[20]/DTR1/SCL1)
Y-MOT-EN: R1.1, R53.2, SV10.16
Y-RX: SV10.10, U1.91 (P1[9]/ENET_RXD0)
Y-SLP: SV10.6
Y-STP: SV10.4, U1.59 (P0[19]/DSR1/SDA1)
YBMA1: C73.2, IC5.40 (BMA1), Q13.10 (D1), Q14.4 (S1), SV11.9
YBMA2: C72.1, IC5.37 (BMA2), Q13.9 (D2), Q14.5 (S2), SV11.7
YBMB1: C69.2, IC5.48 (BMB1), Q11.10 (D1), Q12.4 (S1), SV11.11
YBMB2: C68.1, IC5.45 (BMB2), Q11.9 (D2), Q12.5 (S2), SV11.5
YCA1: C73.1, IC5.42 (CA1)
YCA2: C72.2, IC5.35 (CA2)
YCB1: C69.1, IC5.2 (CB1)
YCB2: C68.2, IC5.43 (CB2)
YDIR: IC5.18 (REFR_DIR), SV10.1
YDRIVERGND: C60.2, C61.2, C63.2, C64.1, C66.2, C67.2, C70.1, C71.2, C74.1, C75.2, IC5.6 (GNDA), IC5.11 (TST_MODE), IC5.19 (GNDD), IC5.30 (GNDD_2), IC5.49 (GNDP), R46.1, R49.2, R51.1, R52.2, SV11.3, SV11.15
YDRIVERVBB: C60.1, C61.1, C63.1, C65.2, C67.1, C71.1, C75.1, IC5.4 (VSA), IC5.33 (VS), Q12.9 (D2), Q12.10 (D1), Q14.9 (D2), Q14.10 (D1), SV11.1
YDRIVERVSS: C66.1, IC5.20 (VCC_IO), IC5.21 (SD_MODE), IC5.22 (SPI_MODE), SV11.13
YENABLE: IC5.28 (DRV_ENN), SV10.15
YHA1: IC5.41 (HA1), Q14.1 (G1)
YHA2: IC5.36 (HA2), Q14.8 (G2)
YHB1: IC5.1 (HB1), Q12.1 (G1)
YHB2: IC5.44 (HB2), Q12.8 (G2)
YLA1: IC5.39 (LA1), Q13.1 (G1)
YLA2: IC5.38 (LA2), Q13.8 (G2)
YLB1: IC5.47 (LB1), Q11.1 (G1)
YLB2: IC5.46 (LB2), Q11.8 (G2)
YMIN: R28.2, U1.44 (P1[28]/MCOA2/PCAP1[0]/MAT0[0])
YMOTORMISO: IC5.16 (SDO_CFG0), SV10.7
YMOTORMOSI: IC5.15 (SDI_CFG1), SV10.13
YMOTORSCK: IC5.14 (SCK_CFG2), SV10.11
YRX: IC5.13 (CSN_CFG3), SV10.9
YSLP: IC5.12 (CLK), SV10.5
YSRAH: IC5.8 (SRAH), R47.1
YSRAL: IC5.7 (SRAL), R51.2
YSRBH: IC5.9 (SRBH), R48.1
YSRBL: IC5.10 (SRBL), R46.2
YSTP: IC5.17 (REFL_STEP), SV10.3
Z1A: SV14.10, SV15.2
Z1B: SV14.12, SV15.1
Z2A: SV14.8, SV15.3
Z2B: SV14.6, SV15.4
Z-DIR: SV13.2, U1.52 (P2[11]/!EINT1/I2STX_CLK)
Z-MOT-EN: R2.1, R61.2, SV13.16
Z-RX: SV13.10, U1.92 (P1[8]/ENET_CRS)
Z-SLP: SV13.6
Z-STP: SV13.4, U1.56 (P0[22]/RTS1/TD1)
ZBMA1: C89.2, IC6.40 (BMA1), Q17.10 (D1), Q18.4 (S1), SV14.9
ZBMA2: C88.1, IC6.37 (BMA2), Q17.9 (D2), Q18.5 (S2), SV14.7
ZBMB1: C85.2, IC6.48 (BMB1), Q15.10 (D1), Q16.4 (S1), SV14.11
ZBMB2: C84.1, IC6.45 (BMB2), Q15.9 (D2), Q16.5 (S2), SV14.5
ZCA1: C89.1, IC6.42 (CA1)
ZCA2: C88.2, IC6.35 (CA2)
ZCB1: C85.1, IC6.2 (CB1)
ZCB2: C84.2, IC6.43 (CB2)
ZDIR: IC6.18 (REFR_DIR), SV13.1
ZDRIVERGND: C76.2, C77.2, C79.2, C80.1, C82.2, C83.2, C86.1, C87.2, C90.1, C91.2, IC6.6 (GNDA), IC6.11 (TST_MODE), IC6.19 (GNDD), IC6.30 (GNDD_2), IC6.49 (GNDP), R54.1, R57.2, R59.1, R60.2, SV14.3, SV14.15
ZDRIVERVBB: C76.1, C77.1, C79.1, C81.2, C83.1, C87.1, C91.1, IC6.4 (VSA), IC6.33 (VS), Q16.9 (D2), Q16.10 (D1), Q18.9 (D2), Q18.10 (D1), SV14.1
ZDRIVERVSS: C82.1, IC6.20 (VCC_IO), IC6.21 (SD_MODE), IC6.22 (SPI_MODE), SV14.13
ZENABLE: IC6.28 (DRV_ENN), SV13.15
ZHA1: IC6.41 (HA1), Q18.1 (G1)
ZHA2: IC6.36 (HA2), Q18.8 (G2)
ZHB1: IC6.1 (HB1), Q16.1 (G1)
ZHB2: IC6.44 (HB2), Q16.8 (G2)
ZLA1: IC6.39 (LA1), Q17.1 (G1)
ZLA2: IC6.38 (LA2), Q17.8 (G2)
ZLB1: IC6.47 (LB1), Q15.1 (G1)
ZLB2: IC6.46 (LB2), Q15.8 (G2)
ZMIN: R30.2, U1.43 (P1[27]/CLKOUT/!USB_OVRCR/CAP0[1])
ZMOTORMISO: IC6.16 (SDO_CFG0), SV13.7
ZMOTORMOSI: IC6.15 (SDI_CFG1), SV13.13
ZMOTORSCK: IC6.14 (SCK_CFG2), SV13.11
ZRX: IC6.13 (CSN_CFG3), SV13.9
ZSLP: IC6.12 (CLK), SV13.5
ZSRAH: IC6.8 (SRAH), R55.1
ZSRAL: IC6.7 (SRAL), R59.2
ZSRBH: IC6.9 (SRBH), R56.1
ZSRBL: IC6.10 (SRBL), R54.2
ZSTP: IC6.17 (REFL_STEP), SV13.3

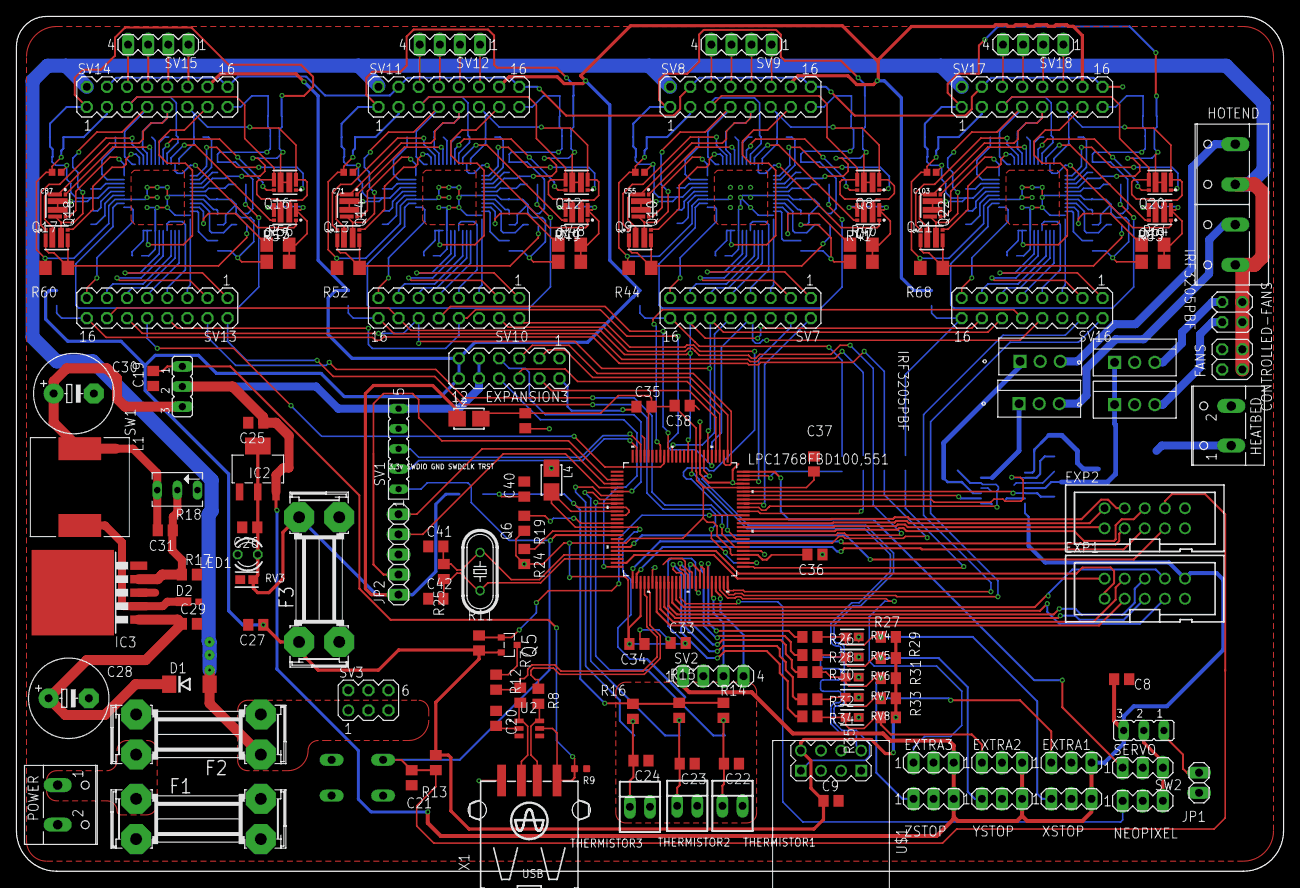
[picture p6: board Motherboard V1.1.brd from above]

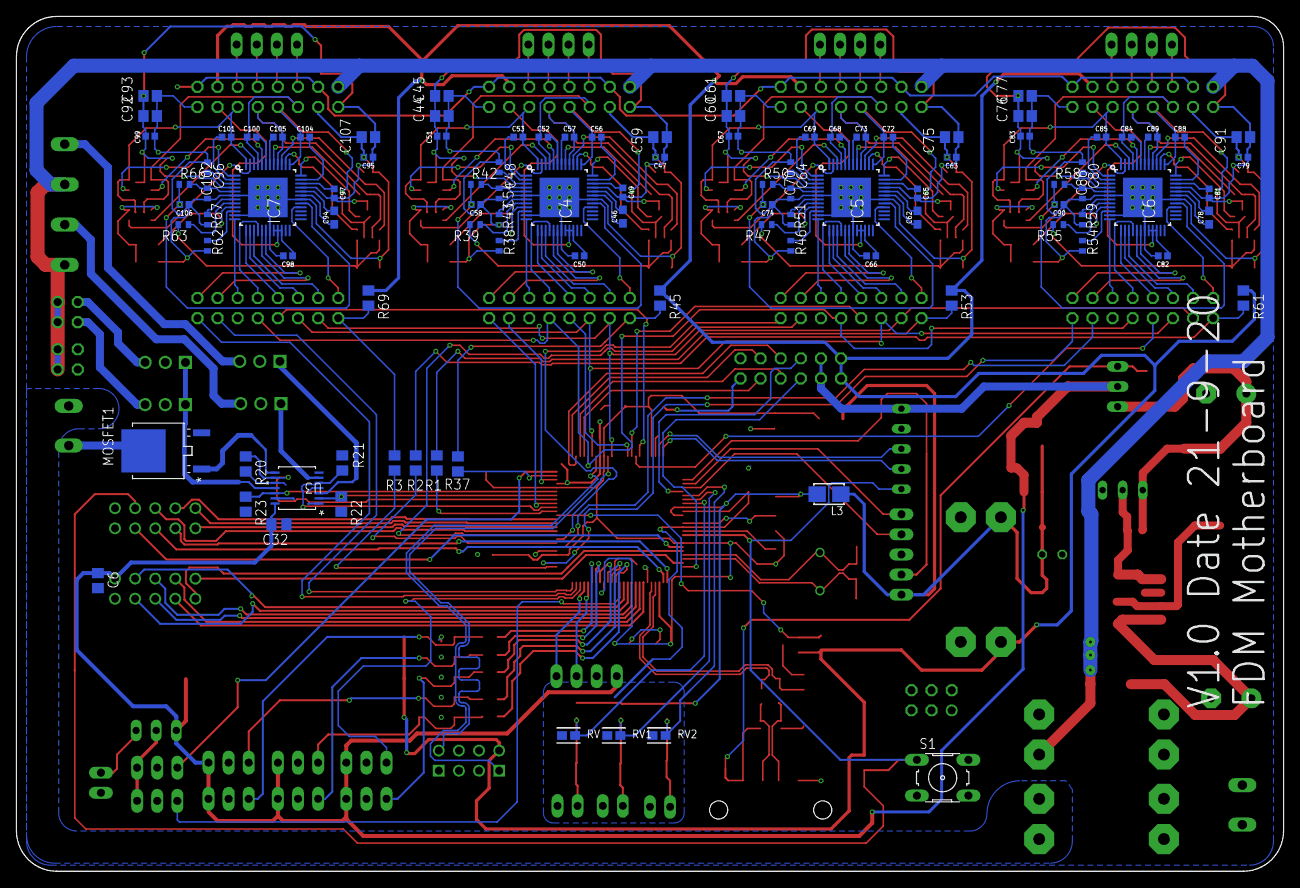
[picture p7: board Motherboard V1.1.brd from below]

Board: 2 copper layers, 160.0 x 108.0 mm, 247 parts (101 on the bottom side), 283 nets.
