seifmostafa73/3D-Printer/(commit log)

2022-03-11 Uploaded mother board v1.0 and v1.1
    [BOM.xlsx, Motherboard V1.1.brd, Motherboard V1.1.sch, Motherboard.brd, Motherboard.sch, MotherboardV1.1 BOM.xlsx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]
2022-03-11 Uploaded the replaceable motor driver module
    [Contactless.brd, Contactless.sch, untitled.brd, untitled.sch]
2022-04-24 Uploaded BOM for version 1.1
    [Motherboard BOMV1.1.csv, MouserBOMv1.1.xls]
