seifmostafa73/3D-Printer/(notices)

Notices in the files:
parts and their libraries:
LPC1768: COPYRIGHT: Copyright (C) 2016 Accelerated Designs. All rights reserved
ESP: Released under the Creative Commons Attribution 4.0 International License: http://creativecommons.org/licenses/by/4.0
IRF3205PBF: COPYRIGHT: Copyright (C) 2018 Accelerated Designs. All rights reserved
